wgbowley/CoilGun/media/images/5-stages-finished.jpg

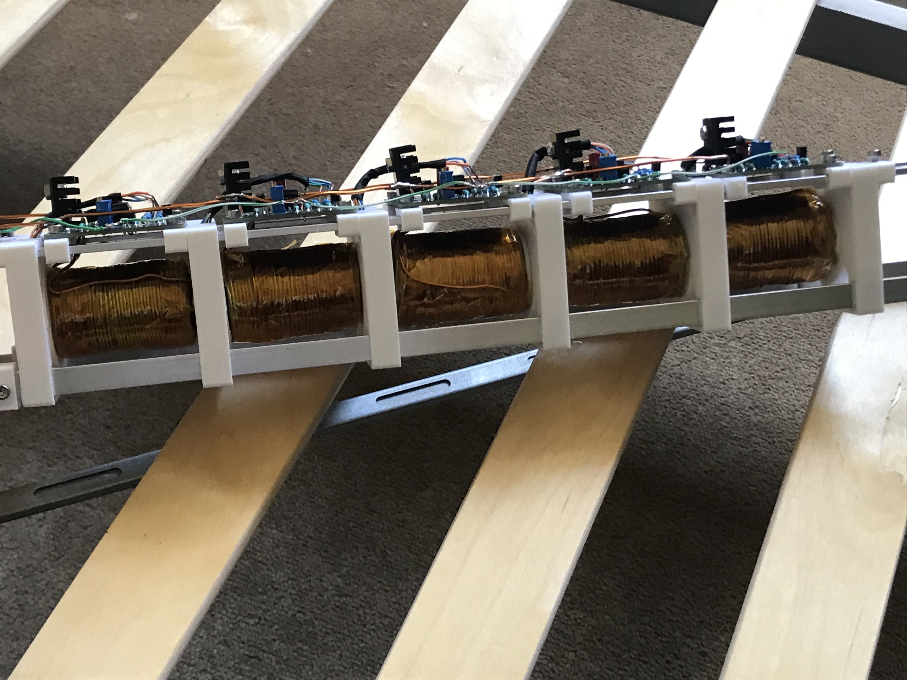
media/images/5-stages-finished.jpg
