wgbowley/CoilGun/media/images/20-stages-graph.png

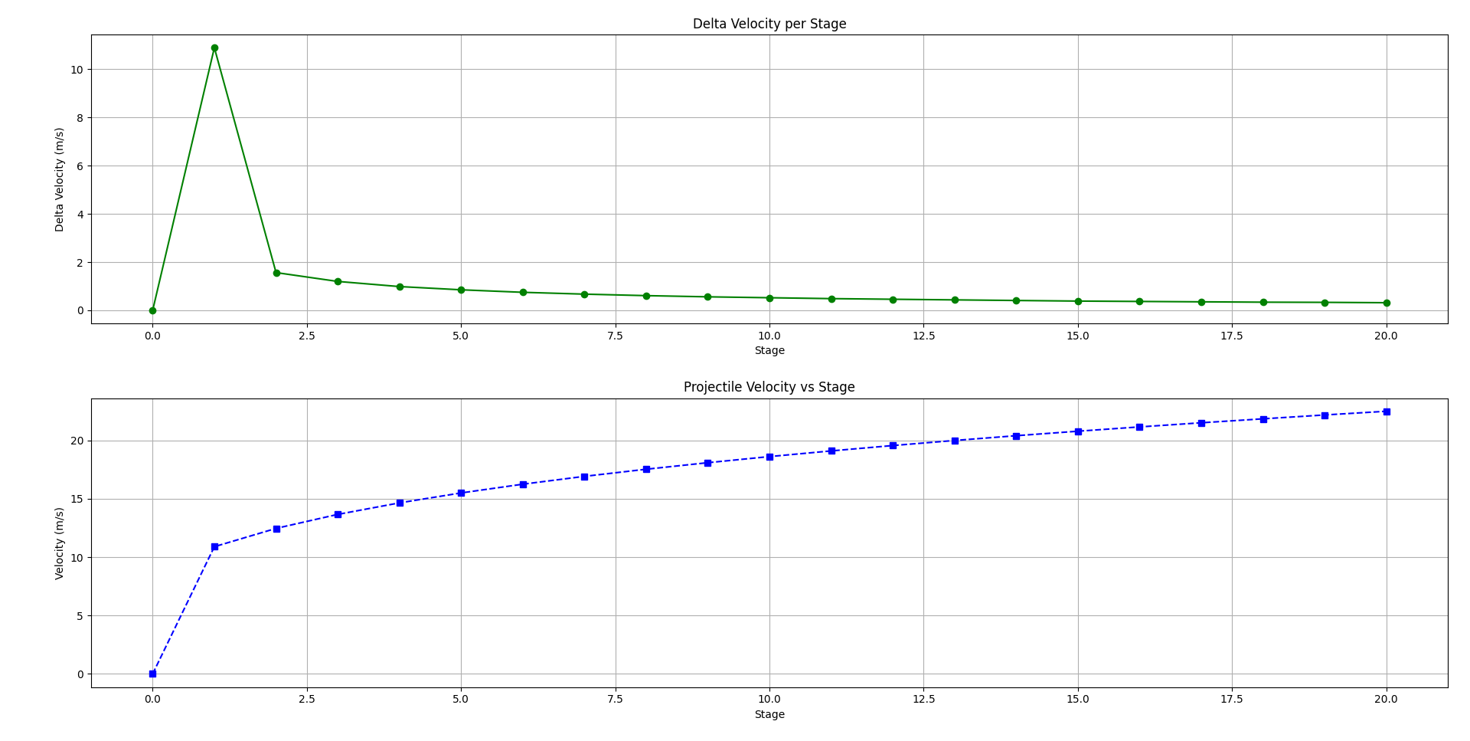
media/images/20-stages-graph.png
