wgbowley/CoilGun/media/images/Coil&DriverBoard.jpg

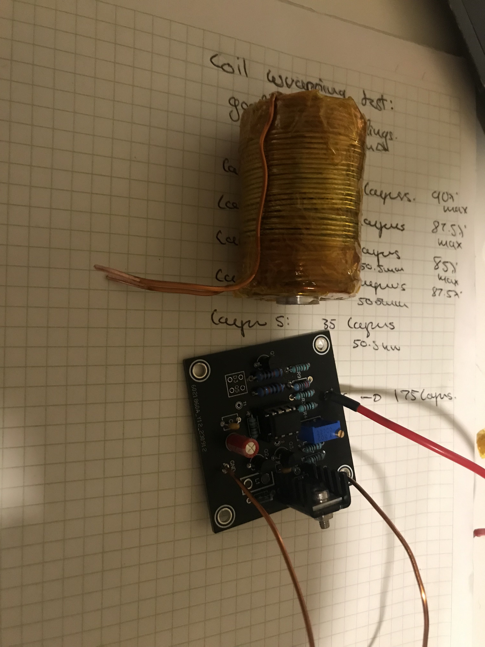
media/images/Coil&DriverBoard.jpg
