wgbowley/CoilGun/media/images/Finite-element-magnetic-methods-output.png

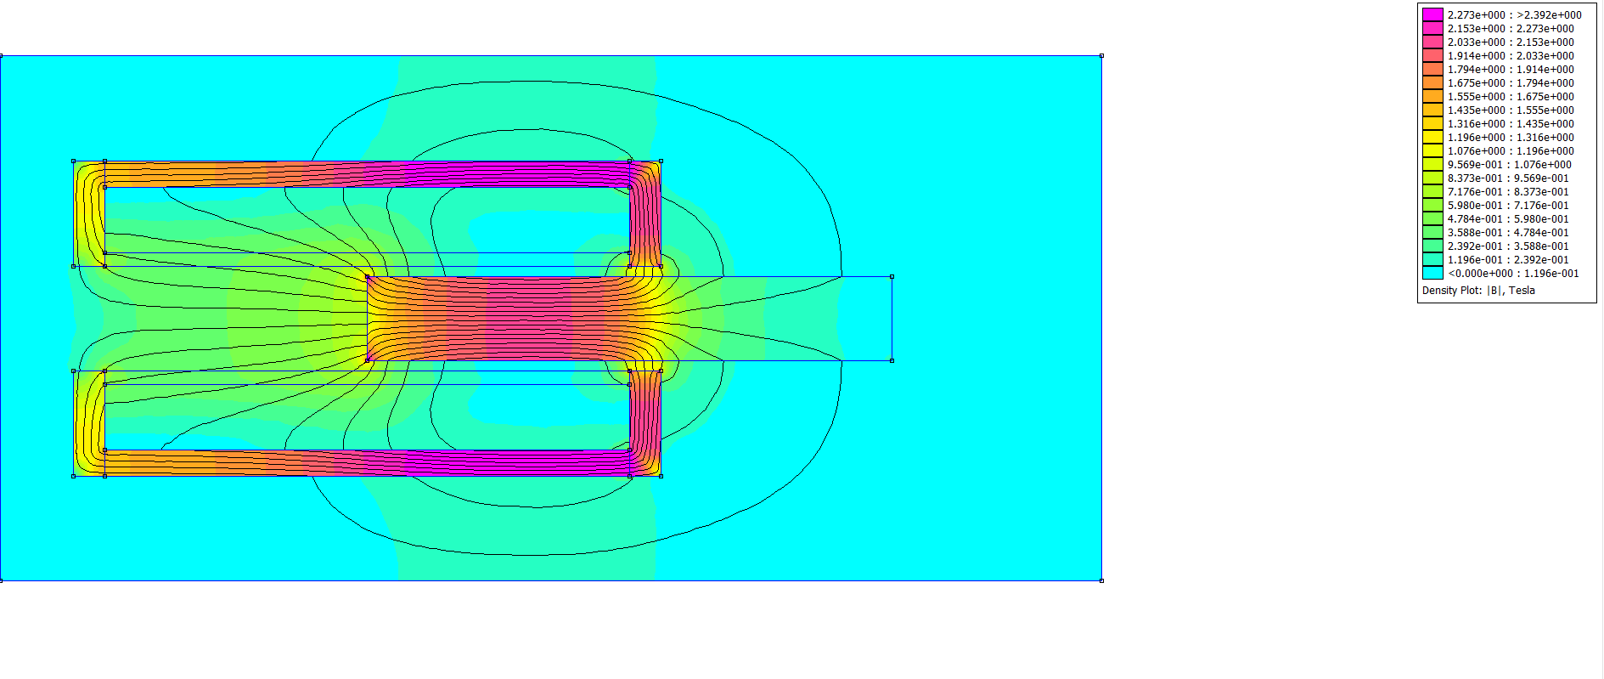
media/images/Finite-element-magnetic-methods-output.png
