wgbowley/CoilGun/circuit_schematic/Electromagnetic-coil-gun-v1.pdf

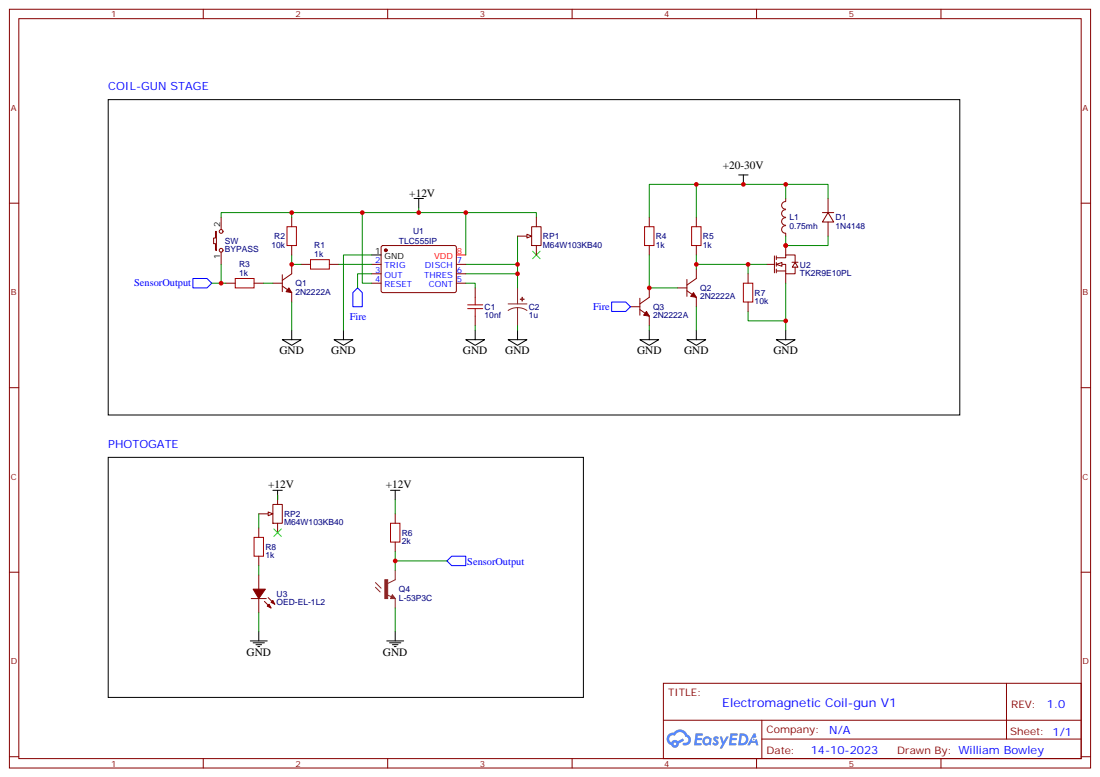
[picture p8: page 1]

Drawn By: William Bowley
