wgbowley/CoilGun/ltspice_model/coil-gun-circuit.asc

C2: cap; 10nf
C3: cap; 1µf
D1: diode; 1N4148
L1: ind; 0.750mh; Rser=0.45
M1: nmos; IPP05CN10L
Q1: npn; 2N2222
Q2: npn; 2N2222
Q3: npn; 2N2222
R1: res; 1k
R2: res; 1k
R3: res; 1k
R4: res; 1k
R5: res; 1k
R6: res; 10k
R7: res; 1k
R8: res; 10k
U1: NE555
V1: voltage; 18
V2: voltage; 12V
V3: voltage; PULSE(0 5 0 0 0 5ms 25ms 3)
Named nets: 0, Fire, SensorOutput
This isn't the same NMOS
as the one in the schematic
Fire Switch (Bypass)
Coil-Gun Simulated Circuit - William Bowley (15 October 2023)
.tran 100ms UIC
Change R4 to increase pulse width 
for smaller projectiles.
 
T = St + 1.1(R4)(C3)
