wgbowley/CoilGun/(commit log)

2025-05-08 Achieving Project
    I had planned to continue to version 2, but it's been nearly 2 years, and I’ve since moved on to other projects.
2025-05-13 3 Stage Coil-Gun Photo From EDS1300D
